Serggy10/17.-TFM-Piezoelectric-Harvester/Hardware/Datasheets/bq25505(70_Design_Help_V1_3.xlsx

User Input | VBIAS | 1.21 | V
Fixed
 | Comparator threshold for VSTOR of charger. |  |  |  |  | Comparator threshold voltages indicating when |  |  |  |  | For the bq25570 only, comparator threshold |  |  |  |  | Maximum power point threshold, e.g. ~0.7-0.8 of
 | Typically the max storage element voltage, |  |  |  |  | VSTOR has risen above VBAT_OK_HYST or fallen |  |  |  |  | for VOUT of buck converter. |  |  |  |  | solar panel's open circuit voltage.
 | e.g. 4.2V for LiIon battery. |  |  |  |  | below VBAT_OK.
 | VBAT_UV < VBAT_OV < 5.5V |  |  |  |  | VBAT_OV > VBAT_OK_HYST > VBAT_UV |  |  |  |  | 1.3V < VOUT < VBAT_OV |  |  |  |  | MPPT
Desired |  |  |  |  |  | RSUM1 | 13 | MW |  |  |  |  |  |  |  | RSUM1 | 20 | MW
Desired | RSUM1 | 13 | MW |  |  | VBAT_OK | 2.8 | V | > VBAT_UV |  | RSUM1 | 13 | MW |  |  | VIN_DC(OC) | 2 | V | Open Circuit Volts
Desired | VBAT_OV | 4.2 | V |  |  | VBAT_OK_HYST | 3.1 | V | > VBAT_OK |  | VOUT | 3.3 | V |  |  | VREF_SAMP | 0.8 | V | MPP voltage
 |  |  |  |  |  |  |  | closest 1% resistor1 |  |  |  |  |  |  |  |  |  | closest 1% resistor1
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
