Serggy10/17.-TFM-Piezoelectric-Harvester/Hardware/Captura de pantalla 2025-06-03 212117.png

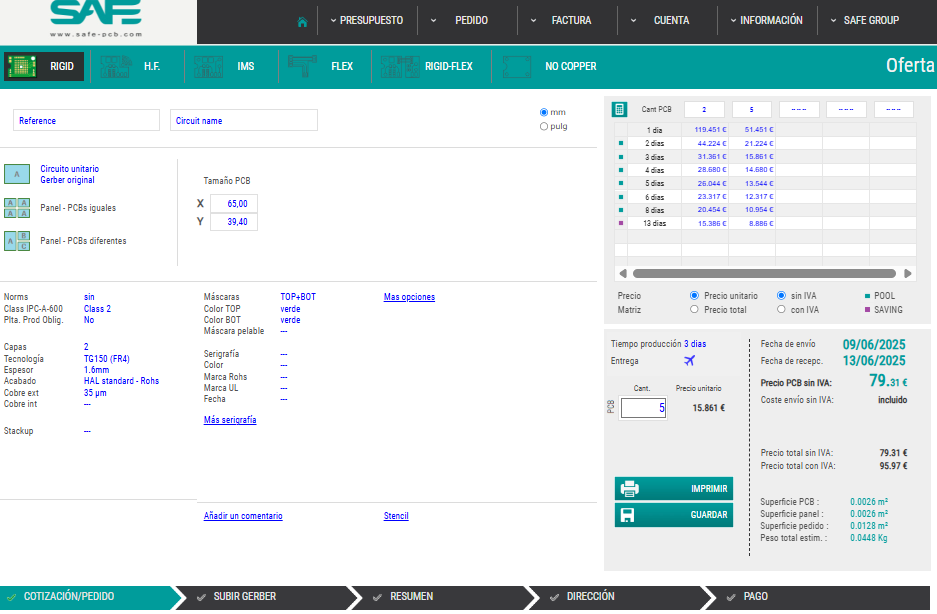
Hardware/Captura de pantalla 2025-06-03 212117.png
