Serggy10/17.-TFM-Piezoelectric-Harvester/Hardware/Esquema_V1.pdf

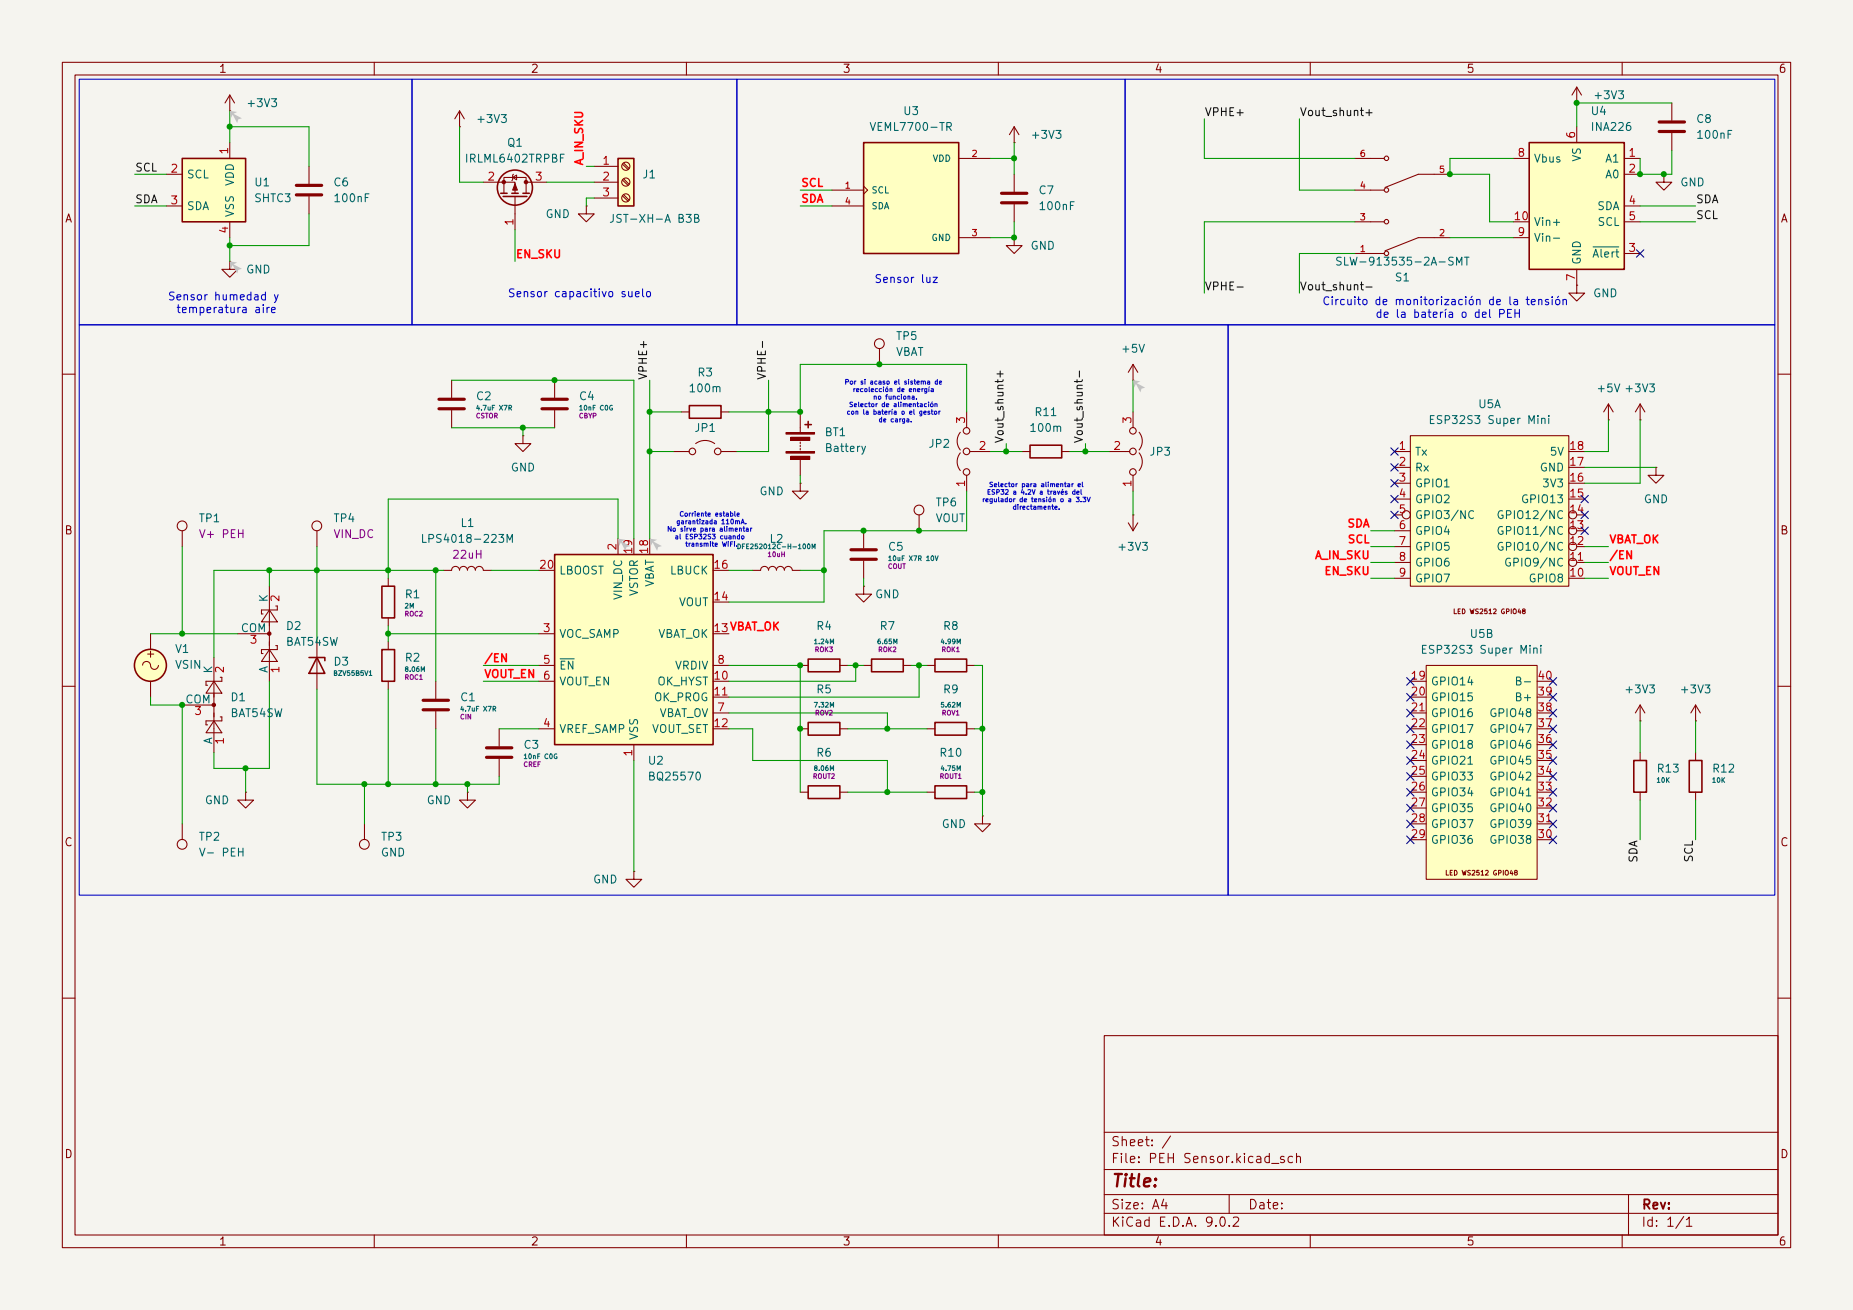
[picture p2: page 1]
