Serggy10/17.-TFM-Piezoelectric-Harvester/Hardware/Layout F mask.pdf

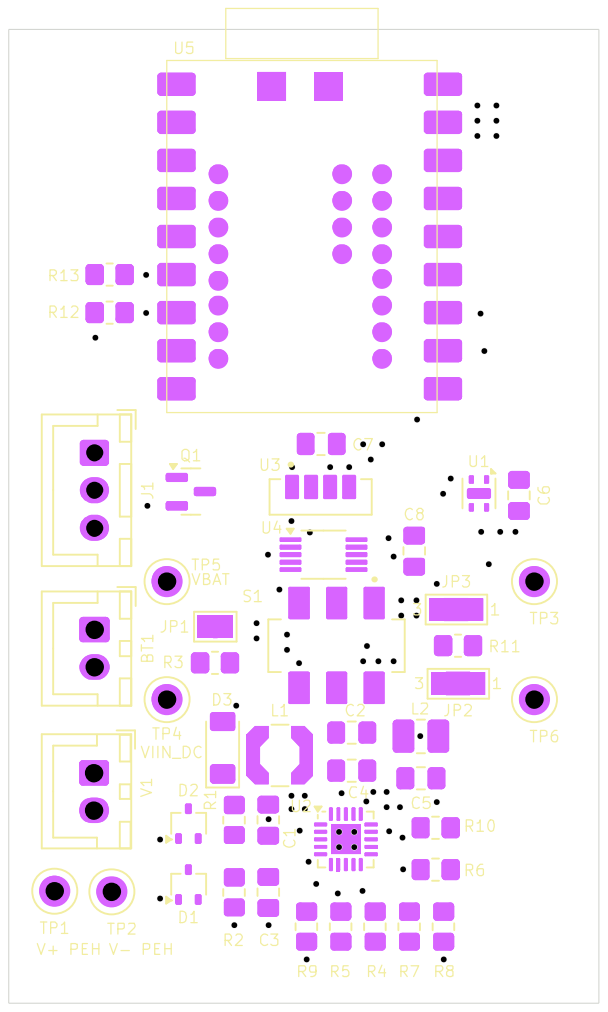
[picture p3: page 1]
