Serggy10/17.-TFM-Piezoelectric-Harvester/Hardware/Layout F.pdf

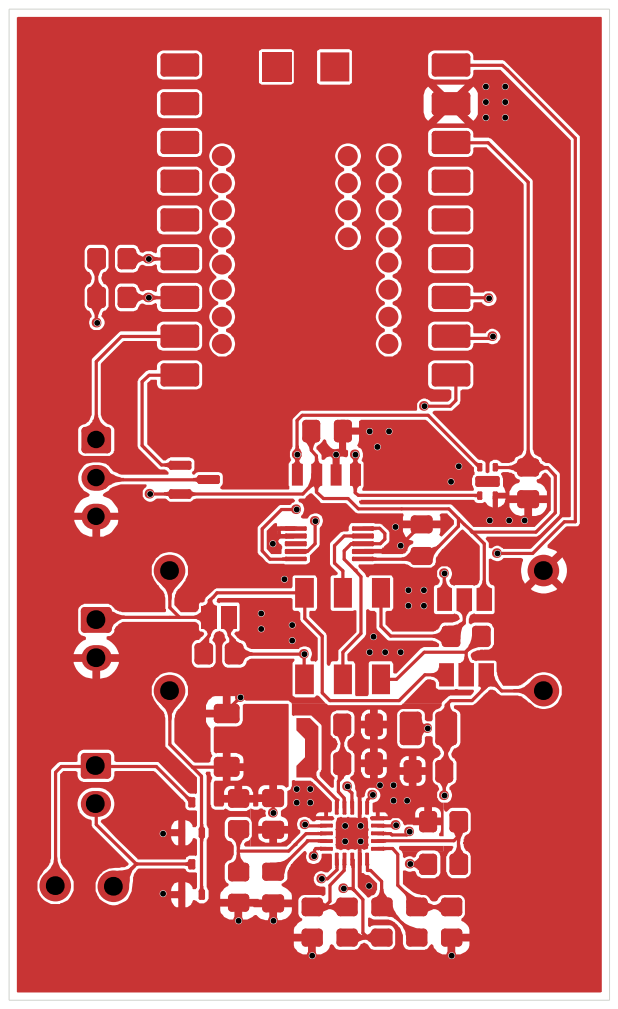
[picture p4: page 1]
