Serggy10/17.-TFM-Piezoelectric-Harvester/Hardware/PEH Sensor/PEH Sensor.kicad_pcb

## KiCad design Hardware/PEH Sensor/PEH Sensor.kicad_pcb (2025-06-25)

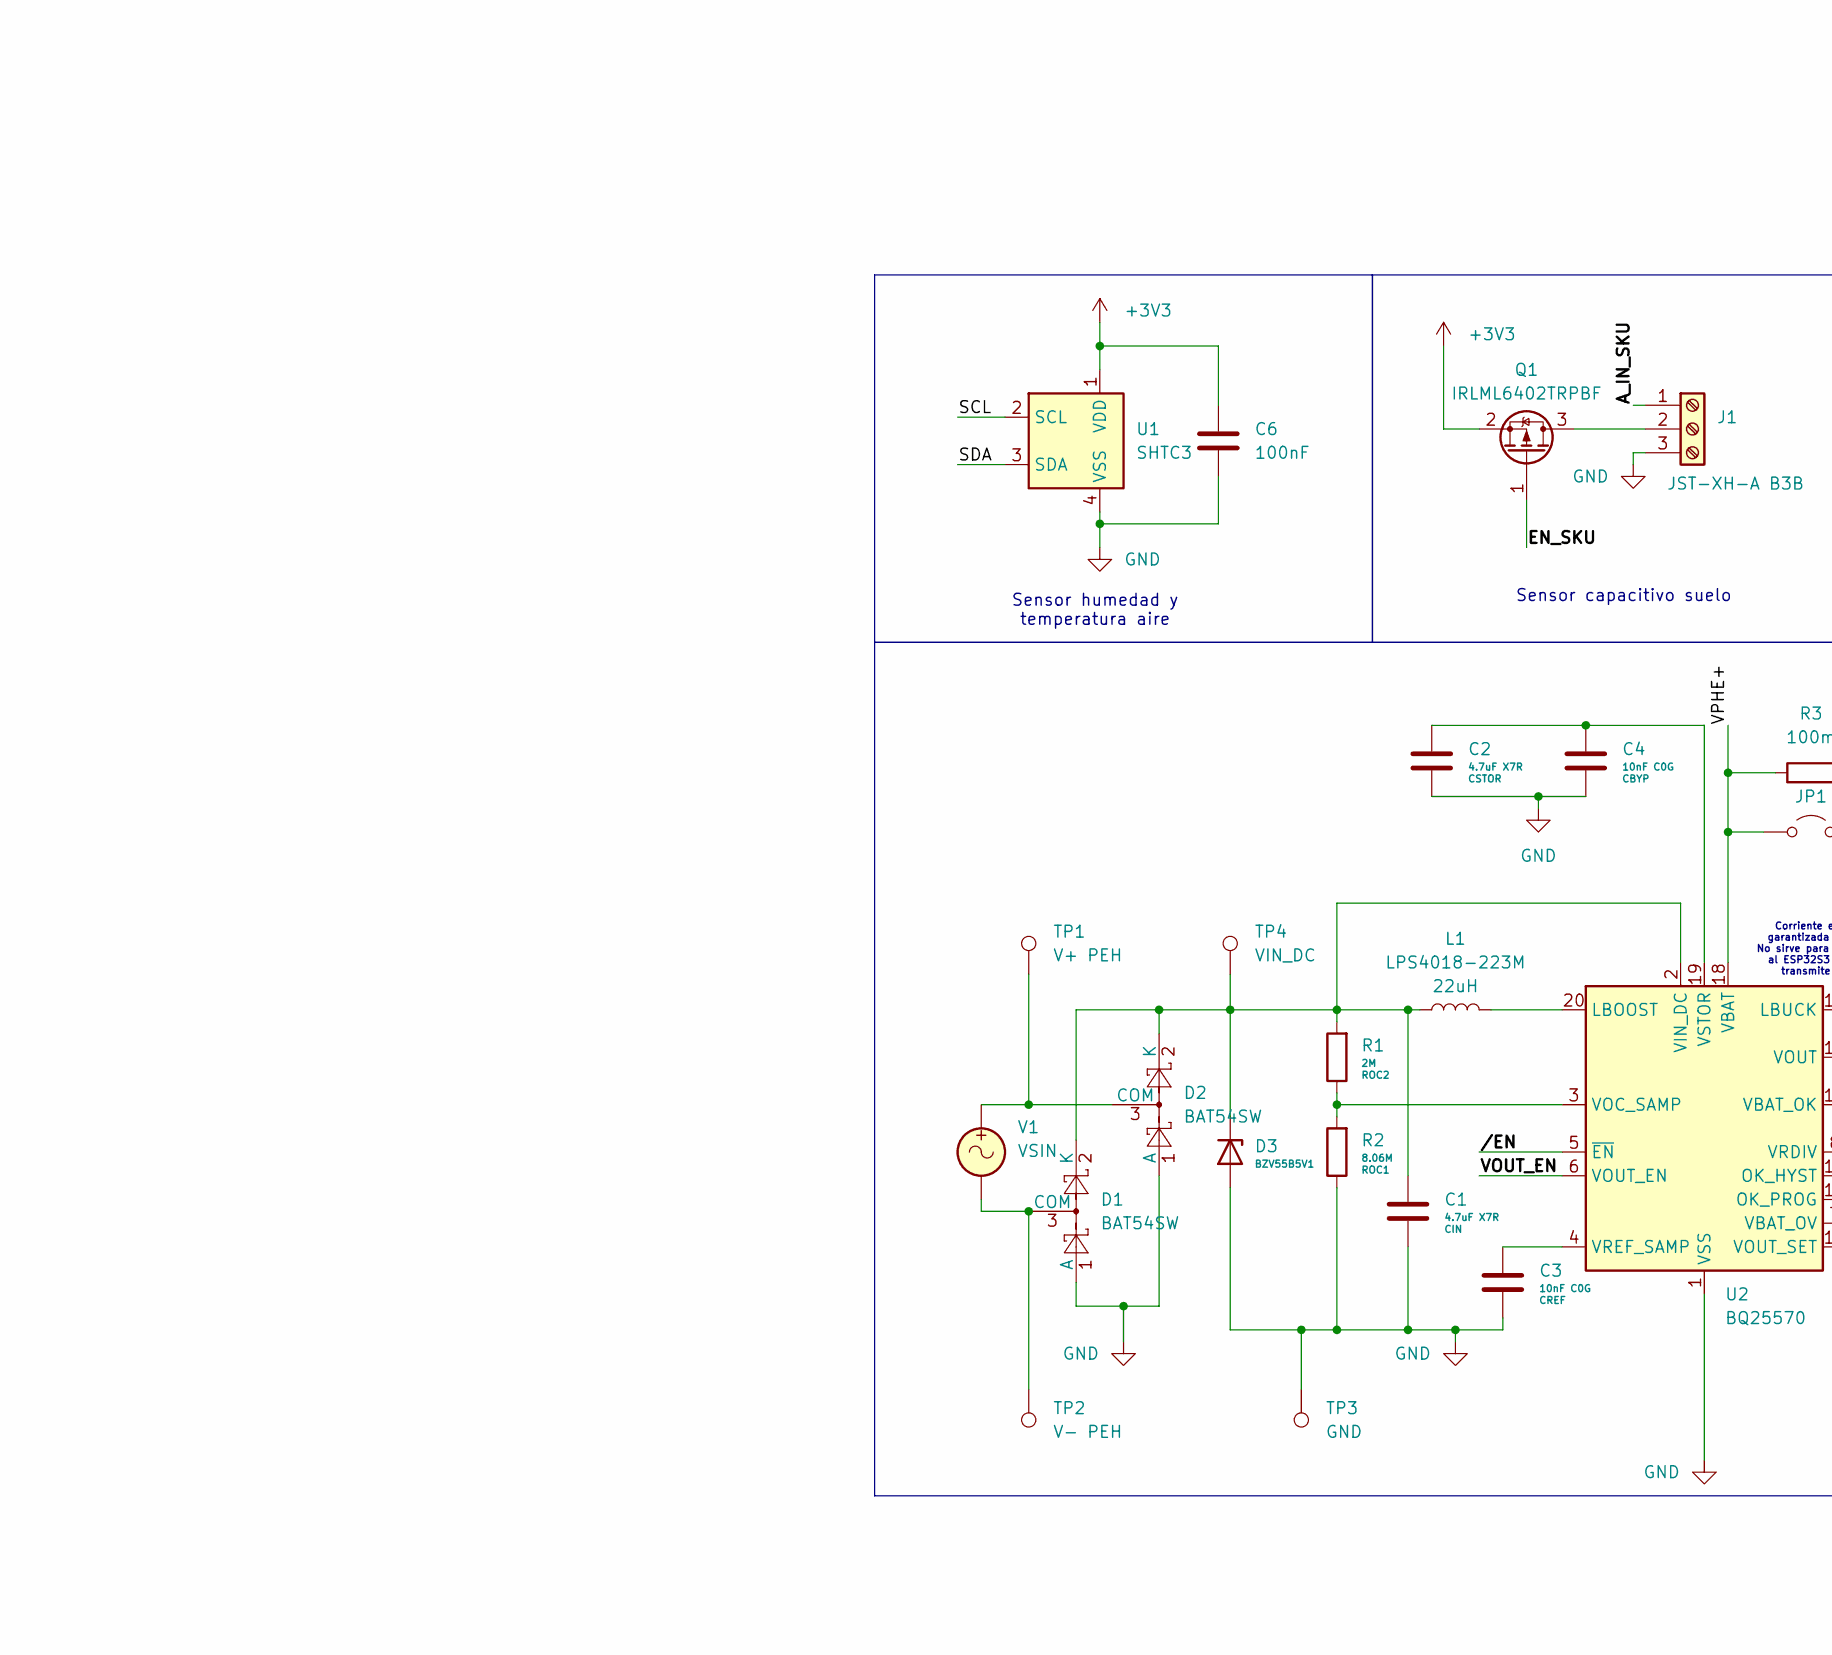
[picture p15: schematic PEH Sensor.kicad_sch, part in row 1, column 2]

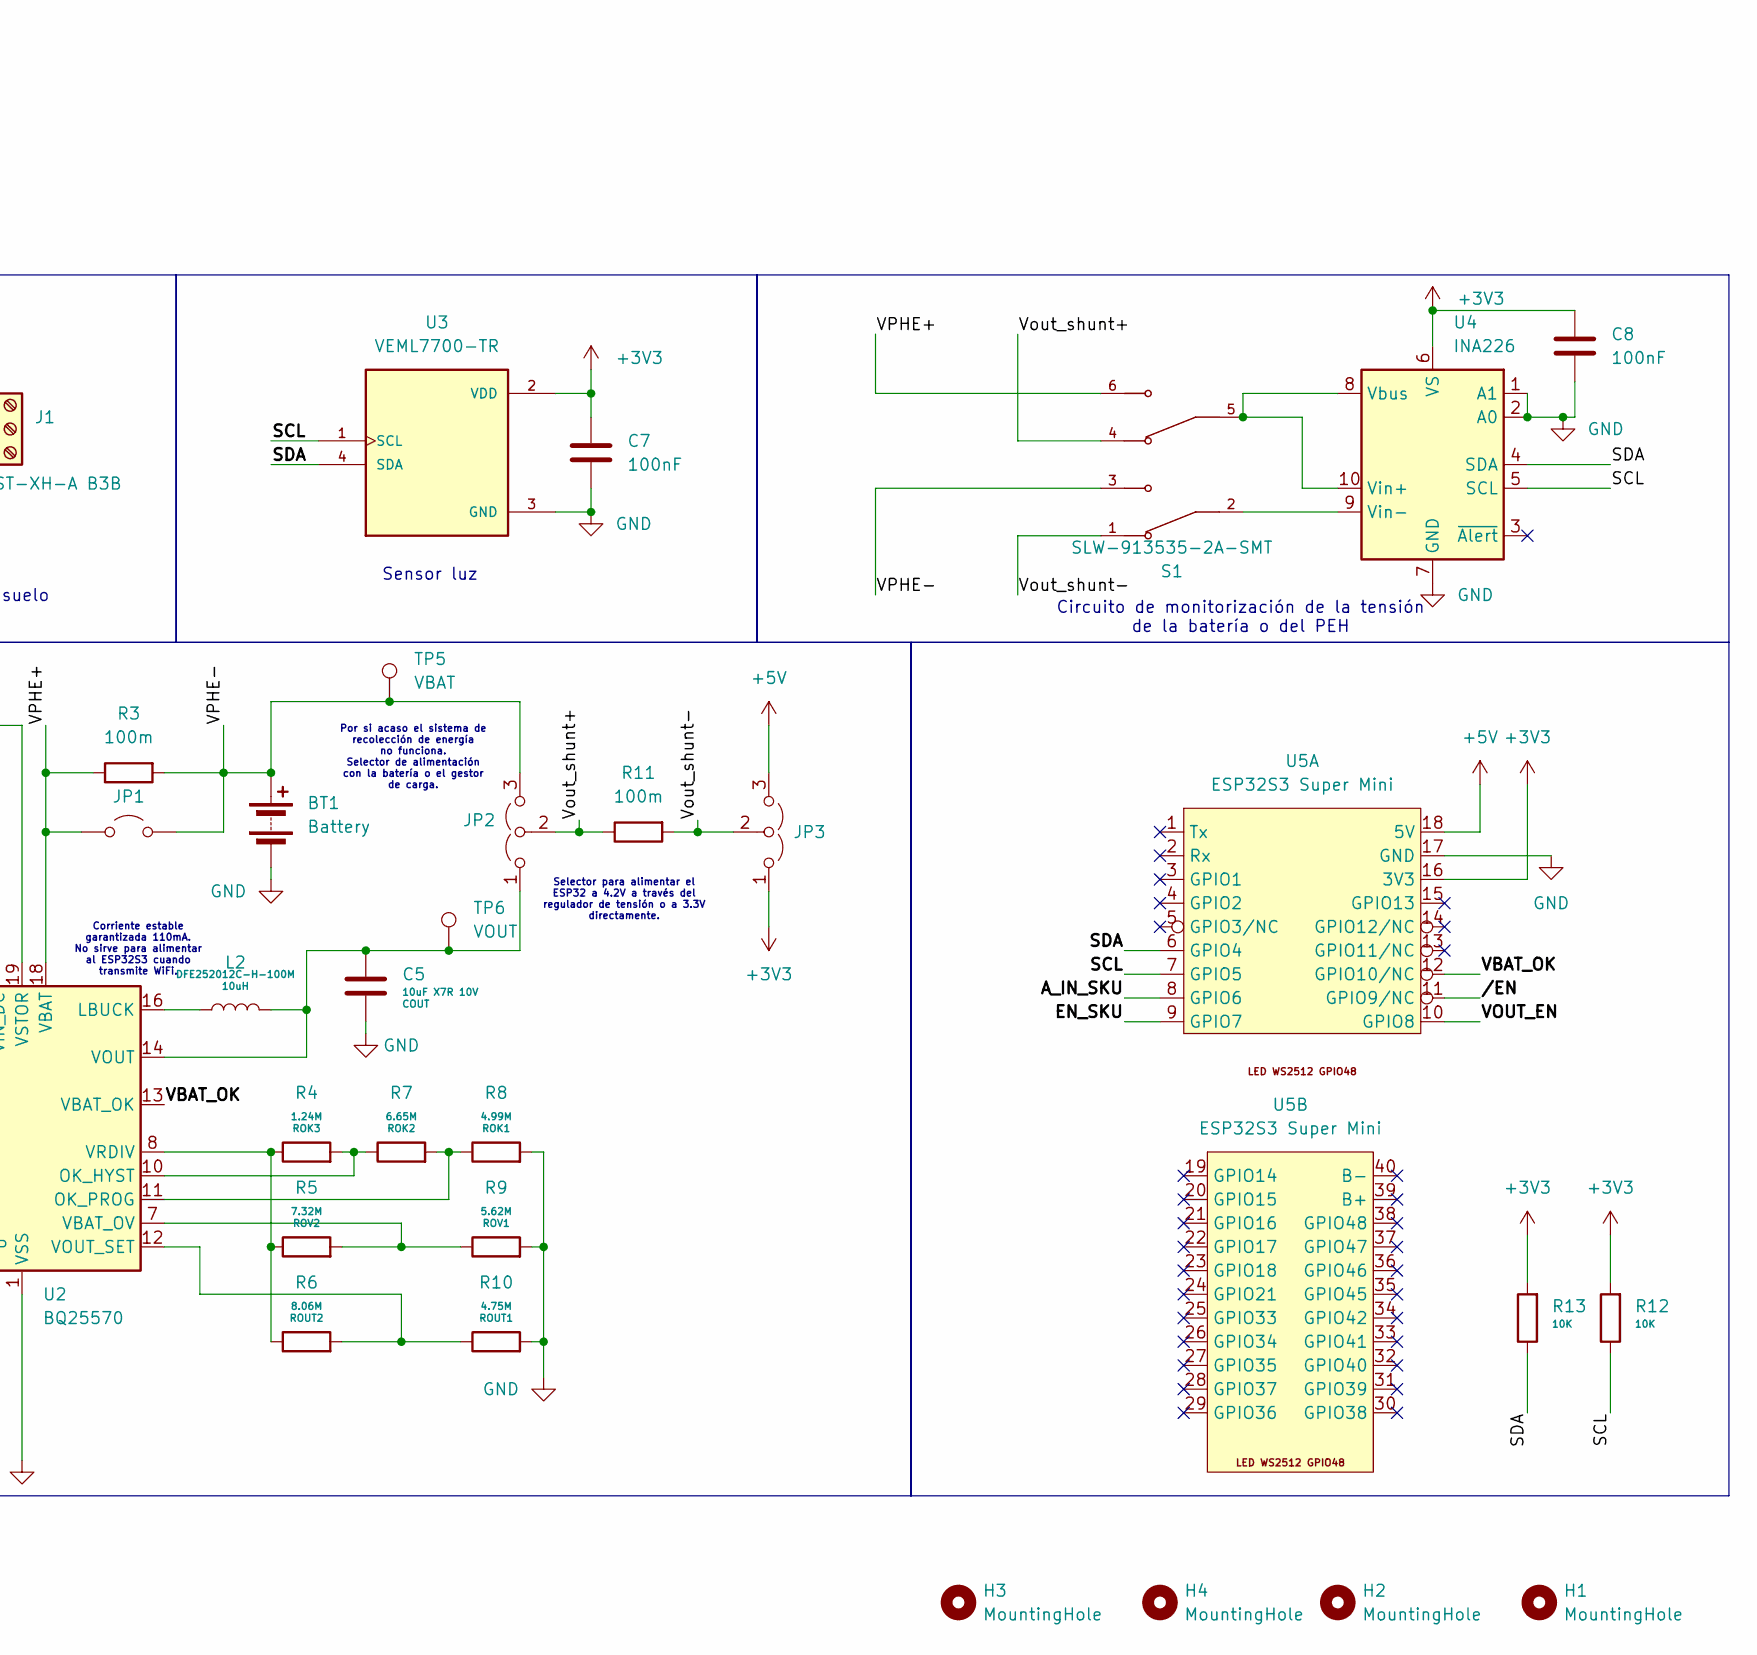
[picture p16: schematic PEH Sensor.kicad_sch, part in row 1, column 3]

Parts:
BT1: Battery; JST_XH_B2B-XH-A_1x02_P2.50mm_Vertical
C1, C2: 4.7uF X7R; C_0805_2012Metric_Pad1.18x1.45mm_HandSolder
C3, C4: 10nF C0G; C_0805_2012Metric_Pad1.18x1.45mm_HandSolder
C5: 10uF X7R 10V; C_0805_2012Metric_Pad1.18x1.45mm_HandSolder
C6, C7, C8: 100nF; C_0805_2012Metric_Pad1.18x1.45mm_HandSolder
D1, D2: BAT54SW; SOT-323_SC-70
D3: BZV55B5V1; D_MiniMELF
H1, H2, H3, H4: MountingHole; MountingHole_3.2mm_M3_DIN965
J1: JST-XH-A B3B; JST_XH_B3B-XH-A_1x03_P2.50mm_Vertical
JP1: Jumper_2_Open; SolderJumper-2_P1.3mm_Open_Pad1.0x1.5mm
JP2, JP3: Jumper_3_Open; SolderJumper-3_P1.3mm_Open_Pad1.0x1.5mm_NumberLabels
L1: LPS4018-223M; L_Coilcraft_LPS4018
L2: DFE252012C-H-100M; L_1008_2520Metric_Pad1.43x2.20mm_HandSolder
Q1: IRLML6402TRPBF; SOT-23
R1: 2M; R_0805_2012Metric_Pad1.20x1.40mm_HandSolder
R2, R6: 8.06M; R_0805_2012Metric_Pad1.20x1.40mm_HandSolder
R3, R11: 100m; R_0805_2012Metric_Pad1.20x1.40mm_HandSolder
R4: 1.24M; R_0805_2012Metric_Pad1.20x1.40mm_HandSolder
R5: 7.32M; R_0805_2012Metric_Pad1.20x1.40mm_HandSolder
R7: 6.65M; R_0805_2012Metric_Pad1.20x1.40mm_HandSolder
R8: 4.99M; R_0805_2012Metric_Pad1.20x1.40mm_HandSolder
R9: 5.62M; R_0805_2012Metric_Pad1.20x1.40mm_HandSolder
R10: 4.75M; R_0805_2012Metric_Pad1.20x1.40mm_HandSolder
R12, R13: 10K; R_0805_2012Metric_Pad1.20x1.40mm_HandSolder
S1: SLW-913535-2A-SMT; SW_SLW-913535-2A-SMT; PARTREV 1.01
TP1: V+ PEH; TestPoint_Loop_D1.80mm_Drill1.0mm_Beaded
TP2: V- PEH; TestPoint_Loop_D1.80mm_Drill1.0mm_Beaded
TP3: GND; TestPoint_Loop_D1.80mm_Drill1.0mm_Beaded
TP4: VIN_DC; TestPoint_Loop_D1.80mm_Drill1.0mm_Beaded
TP5: VBAT; TestPoint_Loop_D1.80mm_Drill1.0mm_Beaded
TP6: VOUT; TestPoint_Loop_D1.80mm_Drill1.0mm_Beaded
U1: SHTC3; Sensirion_DFN-4-1EP_2x2mm_P1mm_EP0.7x1.6mm
U2: BQ25570; QFN-20-1EP_3.5x3.5mm_P0.5mm_EP2x2mm
U3: VEML7700-TR; XDCR_VEML7700-TR; PARTREV 1.6
U4: INA226; VSSOP-10_3x3mm_P0.5mm
U5: ESP32S3 Super Mini; ESP32 super mini
V1: VSIN; JST_XH_B2B-XH-A_1x02_P2.50mm_Vertical

Connections:
+3V3: C6.1, C7.1, C8.1, JP3.1 (A), Q1.2 (S), R12.2, R13.2, U1.1 (VDD), U3.2 (VDD), U4.6 (VS), U5.16 (3V3)
+5V: JP3.3 (B), U5.18 (5V)
/A_IN_SKU: J1.1, U5.8 (GPIO6)
/EN_SKU: Q1.1 (G), U5.9 (GPIO7)
/SCL: R12.1, U1.2 (SCL), U3.1 (SCL), U4.5 (SCL), U5.7 (GPIO5)
/SDA: R13.1, U1.3 (SDA), U3.4 (SDA), U4.4 (SDA), U5.6 (GPIO4)
/VBAT_OK: U2.13 (VBAT_OK), U5.12 (GPIO10/NC)
/VOUT_EN: U2.6 (VOUT_EN), U5.10 (GPIO8)
/VPHE+: JP1.1 (A), R3.1, S1.6, U2.18 (VBAT)
/VPHE-: BT1.1 (+), JP1.2 (B), JP2.3 (B), R3.2, S1.3, TP5.1
/Vout_shunt+: JP2.2 (C), R11.1, S1.4
/Vout_shunt-: JP3.2 (C), R11.2, S1.1
//EN: U2.5 (~EN), U5.11 (GPIO9/NC)
GND: BT1.2 (-), C1.2, C2.2, C3.2, C4.2, C5.2, C6.2, C7.2, C8.2, D1.1 (A), D2.1 (A), D3.2 (A), J1.3, R2.1, R8.2, R9.2, R10.2, TP3.1, U1.4 (VSS), U2.1 (VSS), U2.9 (VSS), U2.15 (VSS), U2.17 (VSS), U2.21 (VSS), U3.3 (GND), U4.1 (A1), U4.2 (A0), U4.7 (GND), U5.17 (GND)
unnamed: D1.3 (COM), TP2.1, V1.2
unnamed: C1.1, D1.2 (K), D2.2 (K), D3.1 (K), L1.1, R1.2, TP4.1, U2.2 (VIN_DC)
unnamed: D2.3 (COM), TP1.1, V1.1
unnamed: J1.2, Q1.3 (D)
unnamed: C5.1, JP2.1 (A), L2.2, TP6.1, U2.14 (VOUT)
unnamed: L1.2, U2.20 (LBOOST)
unnamed: L2.1, U2.16 (LBUCK)
unnamed: R4.2, R7.1, U2.10 (OK_HYST)
unnamed: R7.2, R8.1, U2.11 (OK_PROG)
unnamed: R5.2, R9.1, U2.7 (VBAT_OV)
unnamed: R1.1, R2.2, U2.3 (VOC_SAMP)
unnamed: R6.2, R10.1, U2.12 (VOUT_SET)
unnamed: R4.1, R5.1, R6.1, U2.8 (VRDIV)
unnamed: C3.1, U2.4 (VREF_SAMP)
unnamed: C2.1, C4.1, U2.19 (VSTOR)
unnamed: S1.5, U4.8 (Vbus), U4.10 (Vin+)
unnamed: S1.2, U4.9 (Vin-)

Notes on the sheet:
Corriente estable garantizada 110mA. No sirve para alimentar al ESP32S3 cuando transmite WiFi.
Sensor capacitivo suelo
Sensor luz
Circuito de monitorización de la tensión de la batería o del PEH
Por si acaso el sistema de recolección de energía no funciona. Selector de alimentación con la batería o el gestor de carga.
Sensor humedad y temperatura aire
Para superar el cold sart el PEH debe suministrar una potencia para mantener la carga continua.
Selector para alimentar el ESP32 a 4.2V a través del regulador de tensión o a 3.3V directamente.

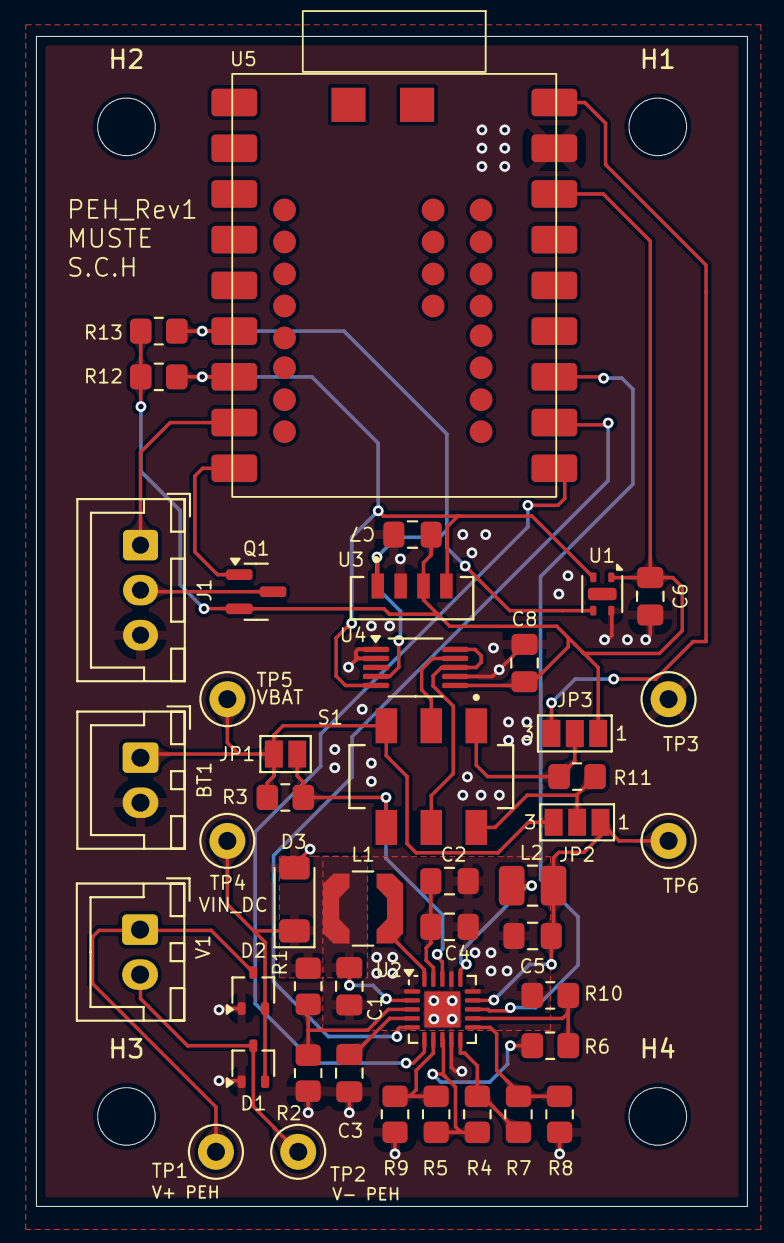
[picture p17: board PEH Sensor.kicad_pcb from above]

Board: 2 copper layers, 39.5 x 65.0 mm, 49 parts (0 on the bottom side), 31 nets.
