Serggy10/17.-TFM-Piezoelectric-Harvester/(commit log)

2025-06-01 Init commit
    [PEH Sensor.kicad_pcb, PEH Sensor.kicad_sch, bq25505(70_Design_Help_V1_3.xlsx]
2025-06-01 Serial monitor working on ESP32-s3 super mini
2025-06-07 Several PCB updates to hardware. Started BLE app on androidstudio.
    [PEH Sensor.kicad_pcb, PEH Sensor.kicad_sch]
2025-06-07 App runing and ESP32 advertising every moment.
2025-06-07 Sending 10 sensor data in 2 packets of 5. Lag in transmision due to the 5 characterisitics.
2025-06-08 Sending 2 pakckets of 25 data (5 of each sensor).
2025-06-08 Updated ESP32 program with deepsleep.
2025-06-25 Programa de prueba de sensores y actualización de PCB con cambio en la librería del VEML770
    [PEH Sensor-B_Cu.gbr, PEH Sensor-B_Mask.gbr, PEH Sensor-B_Paste.gbr, PEH Sensor-B_Silkscreen.gbr, PEH Sensor-Edge_Cuts.gbr, PEH Sensor-F_Cu.gbr, PEH Sensor-F_Mask.gbr, PEH Sensor-F_Paste.gbr]
2025-06-27 Included all the sensors readings and transmision with BLE.
2025-06-29 Added a luminous signal to distinguish between data acquisition, BLE advertising and light/deep sleep mode. A refresh mode with lightsleep has been added to prevent getting stuck when leaving deep sl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
    [main.cpp]
